SwiCago/HarviaWiFi/images/CaptivePortal2.png

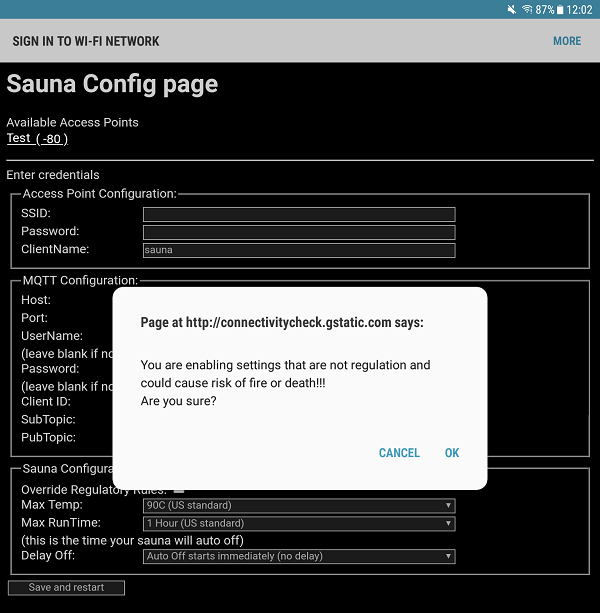
images/CaptivePortal2.png
