SwiCago/HarviaWiFi/images/CaptivePortal3.png

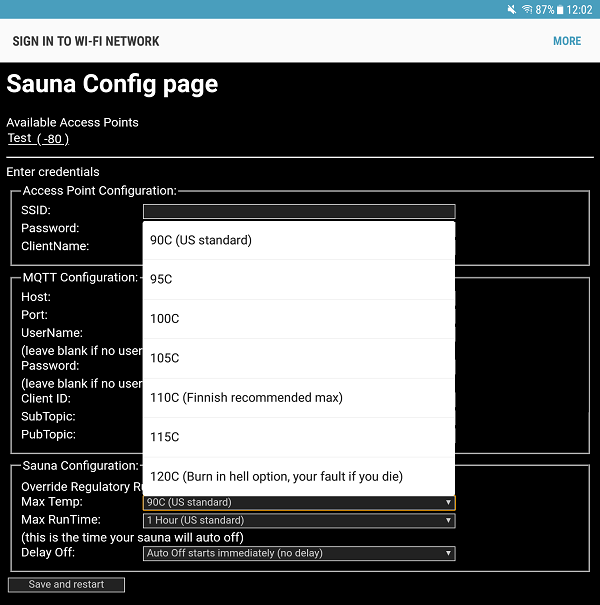
images/CaptivePortal3.png
