SwiCago/HarviaWiFi/images/CaptivePortal5.png

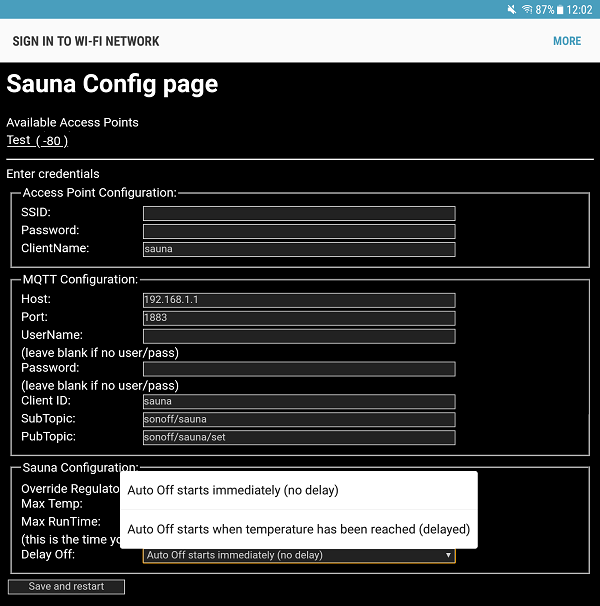
images/CaptivePortal5.png
