SwiCago/HarviaWiFi/images/CaptivePortall4.png

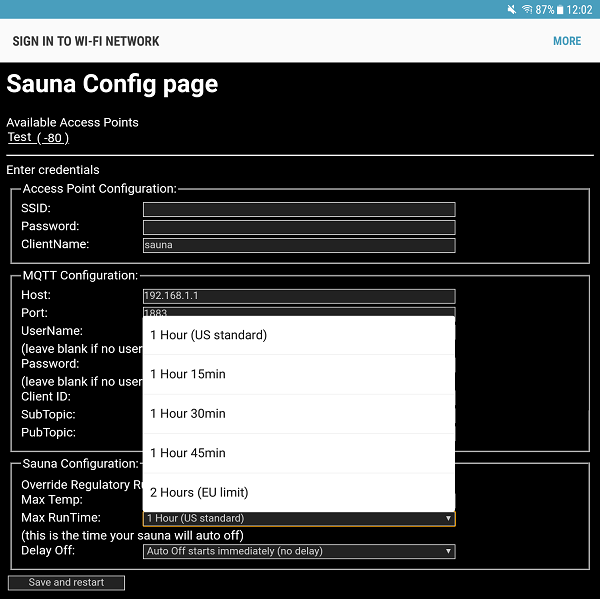
images/CaptivePortall4.png
