SwiCago/HarviaWiFi/(threads)

Thread 3 (2019-03-24):

Upgrade code from JSON 5 to JSON 6 library

SwiCago, 2019-03-24:
Code was written using JSON Arduino library 5 and not 6. If you use this code, please use library 5 to compile.
When I have time, I will upgrade the code to 6 and re-test.

jsk1000, 2019-11-25:
Hi Al,

Do you think the remote set up will work with this heater:  https://almostheaven.com/virta-heater/  - It has an electric keypad to turn it on and control the temp.

Are you able to turn the heater on with your phone when you are away from home?

Thanks in advance,
Jack
Boulder, Colorado
j a c k @ o n n o . c o m

chirojason, 2020-01-19:
Hey Jack,
Did you get it your heater working using this code?

Thanks,
Jason

SwiCago, 2020-02-24:
@jsk1000 @chirojason , wow no idea why github did not send me a notification for this question. Maybe it is because you didn't use @name to tag me. Anyhow, any heater can be converted. Even this digital one! However, you will most likely lose the digital control part, as they would be in conflict with each other over control of the primitive part(the heater).
Only way to keep keypad and make wifi, would be by making your own digital control board and have it understand keypad.

jsk1000, 2020-02-24:
Jason,

Thanks very much for this!  I appreciate it.

Best,
Jack

------ Original Message ------
From: "SwiCago" <notifications@github.com>
To: "SwiCago/HarviaWiFi" <HarviaWiFi@noreply.github.com>
Cc: "Jack Kanefield" <jack@onno.com>; "Mention"
<mention@noreply.github.com>
Sent: 2/24/2020 5:48:45 AM
Subject: Re: [SwiCago/HarviaWiFi] Upgrade code from JSON 5 to JSON 6
library (#3)

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

chirojason, 2020-02-24:
Hey Jack,
Thank you for the reply! I just figured you were really busy or not
interested in the heater build anymore. It has been over a month since I
gave up on it. I did the hardware conversion and added the fuse box to the
heater and things went great, but I could not get the Sauna software you
wrote up and running on my Sonoff. It never loaded the Captive Portal page
which never gave me the option to input my router/wifi details.
After trying many times, I ended up flashing Tasmota and using it to be an
On/Off switch using wifi so I could use my sauna. That loaded up no
problem, but I would really prefer the timer shutoff function you wrote
along with temperature. I will give it another shot this week, but I could
really use some help from someone who has more experience in the Arduino
area. I even subscribed to a few Arduino FB groups and read an Arduino book
to see what I was missing, but no luck.

If you get a few minutes and don't mind helping, I would greatly appreciate
it. I can normally figure these things out myself, but this one I am
stumped on.

Thanks again for your time and hard work documenting the sauna upgrade for
others to use!

Jason Albracht

On Mon, Feb 24, 2020 at 7:26 AM Jack Kanefield <notifications@github.com>
wrote:

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

chirojason, 2020-02-24:
Thank you for the reply! I just figured you were really busy or not
interested in the heater build anymore. It has been over a month since I
gave up on it. I did the hardware conversion and added the fuse box to the
heater and things went great, but I could not get the Sauna software you
wrote up and running on my Sonoff. It never loaded the Captive Portal page
which never gave me the option to input my router/wifi details.
After trying many times, I ended up flashing Tasmota and using it to be an
On/Off switch using wifi so I could use my sauna. That loaded up no
problem, but I would really prefer the timer shutoff function you wrote
along with temperature. I will give it another shot this week, but I could
really use some help from someone who has more experience in the Arduino
area. I even subscribed to a few Arduino FB groups and read an Arduino book
to see what I was missing, but no luck.

If you get a few minutes and don't mind helping, I would greatly appreciate
it. I can normally figure these things out myself, but this one I am
stumped on.

Thanks again for your time and hard work documenting the sauna upgrade for
others to use!

Jason Albracht

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

SwiCago, 2020-02-24:
@chirojason, are you using an iphone or android device? I tested with android, but the page to configure should be accessible at address 192.168.1.1 ... captive portal is just for convenience, but nothing keeps you fro  direct access. Heck, you could modify the code and hardcode all your details and skip the configuration part.

chirojason, 2020-09-10:
Hey SwiCago. I gave up on the sonoff board back in February with all the
corona mess and it got too hot to do the sauna. I still haven't gotten it
to find my IP address. It was working as a basic wifi switch running
Tasmota software but then I got a new router and I can not reload anything
to make it work. Would it be possible to order a new sonoff and have it
shipped to you to load the software you wrote on it and I'll Venmo or
Paypal you money for shipping and for your time if you want? I really need
to get this unit working before it starts getting cold again. My wife
mentioned tonight she's ready to get back to the sauna. I have all the
hardware conversion done and really don't want to switch it back to the
original setup. It's frustrating that I've spent so many hours on it with
no working unit now.
Any help would be so appreciated!

Thanks,
Jason Albracht

<https://www.avast.com/sig-email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>
Virus-free.
www.avast.com
<https://www.avast.com/sig-email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>
<#m_-3978630804419995655_DAB4FAD8-2DD7-40BB-A1B8-4E2AA1F9FDF2>

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

<https://www.avast.com/sig-email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>
Virus-free.
www.avast.com
<https://www.avast.com/sig-email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>
<#DAB4FAD8-2DD7-40BB-A1B8-4E2AA1F9FDF2>

jsk1000, 2020-09-10:
Hi Guys,

I have my heater 'turned on' permanently, bypassing the controls on the
heater.

Then buy a simple on/off wifi switch from amazon, and run current to the
heater when you want the sauna on.  I turn it on with my phone from
anywhere.

This is a super simple solution.

Jack

------ Original Message ------
From: "chirojason" <notifications@github.com>
To: "SwiCago/HarviaWiFi" <HarviaWiFi@noreply.github.com>
Cc: "Jack Kanefield" <jack@onno.com>; "Mention"
<mention@noreply.github.com>
Sent: 9/9/2020 8:09:50 PM
Subject: Re: [SwiCago/HarviaWiFi] Upgrade code from JSON 5 to JSON 6
library (#3)

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

SwiCago, 2020-09-11:
@chirojason , I cannot flash it for you. That would make me liable, if something were not to go as planned. I can however help you when you are ready via email.
@jsk1000 be super careful, bypassing this way could cause runaway heating, if your switch is stuck in on position!

chirojason, 2020-10-18:
@SwiCago , I understand. The world we live in is not what it used to be. Can you send me an email so we can converse that way? Mine is DrAlbracht@gmail.com
Thank you!
Jason

rockguitarpower, 2020-12-06:
Hi @SwiCago, Thanks for putting this all together. I just got an indoor sauna with a Harvia heater and looking to put together this solution.

One thing I'm not clear on is if this is compatible for an iphone (what I use) or if it will only work on android?

Sorry if that's a rookie question

Mike

SwiCago, 2020-12-10:
@rockguitarpower not sure if iphone has mqtt dash app, but I am sure there is an equivalent app.
Just remember you need an mqtt broker for my variation to work or rewrite it to support a built in webservice(pretty easy with esp8266).
Also note, if captive portal does not work when connecting to the devices initial wifi, just point your phones mobile browser to 192.168.1.1, which will bring up the config page.
Cheers

rockguitarpower, 2020-12-10:
cool, thanks for the response. I'll see what I can find and get working

arva-zz, 2020-12-27:
@SwiCago great work. I'm brainstorming as well how to make my sauna smart. On Smart home side I have Home Assistant, some fibaro z-wave dimmers, garage door and gate made smart with sonoff SV (Tasmota firmware) MQTT, some ESP32 sensors etc.. So quite flexible on.

I have Harvia PC90EE heater with a keypad. Here is the manual with electrical scheme on page 13: https://harvia.fi/wp-content/uploads/2017/05/PC70EE_PC90EE_ENDE.pdf

I would like to make it "smart", meaning to controll it and collect some data (temp, humidity). And it would be excellent if the original keypad would work.

There are three scenarios listed by priority:

1. Best would be option to read the dataflow between keypad and control unit. So that the original keypad will remain and it i can control the keypad so to say. I think this would be most complicated as well and i don't think I would be able to reverse engineer it.

2. On the electric scheme there are something like N and P termials with description "optional Control of electric heating". Maybe this would be something i can controll the heater? No documentation on harvia site or internet about this tho.

3. Swap Harvias control unit with a smart switch and losing keypad and some security functions.

So, if you could look into it and maybe help me out with some thoughts so i can move on, I would be greatful.

SwiCago, 2021-01-03:
@arva-zz
1. is your only option here. You'd need a device to dump the data between them. If you are lucky it is a simple serial device. Maybe even the main controller has a secondary serial control for 2. Optional control.
2. Not enough info here. N is neutral and is one Phase(110V)
3. You could do this, but you are missing a limit switch, which prevents your unit from going run away on you, in event of malfunction.

Thread 4 (2020-04-14):

Any suggestions for iOS-based app to use?

sazan1978, 2020-04-14:
@SwiCago Not an issue per se, but do you have any suggestions for using an iOS (iPhone or iPad) app for the sauna control using your code? I got as far as getting the code installed on Sonoff, and wiring the unit into the heater, but need some help getting controls enabled via an app. Using MQTTOOL I get what the unit is publishing -

{"celcius":-127,"fahrenheit":-196.6,"state":0,"active":0,"setpoint":60,"autooff":0}

... but have been unsuccessful in publishing any commands to it. E.g., when I publish {“state”:true} I get !root.success(): invalid JSON on set_topic...

SwiCago, 2020-04-15:
Hi @sazan1978
You publish to sonoff/sauna/set with message {"state":true} to turn it on.
As for app, the closest one I can think of is https://apps.apple.com/us/app/mqtt-buddy/id1252991874
Don't forget, you also need an mqtt broker like mosquito

sazan1978, 2020-04-15:
Thanks! Mqtt buddy doesn’t seem to function anymore. I got the Mosquitto
running and Mqtt Dash in Android emulator on my Mac. Wasn’t able to load
the JSON config comes into Dash, but was able to enter them manually. Good
news - got to communicate with sauna. Bad news - It turned on for a second,
and then the fuse box blew. No major damage, but will need to recheck all
connections. Another mystery is that the temperature readings all come back
as negative temps:

{"celcius":-127,"fahrenheit":-196.6,"state":1,"active":0,"setpoint":60,"autooff":120}

Any suggestions?

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
--
--
Alexey
214.675.2623

SwiCago, 2020-04-17:
As said, negative readings means you have a bad sensor.
Main fuse tripped or one of the bridge fuses or the fuse in the sonoff?
Double, tripple check. There are not many wires, but easy to mess up. On sonoff, one hot goes to L and the other hot to N. But make sure you don't get your hots messed up, otherwise pop.

SwiCago, 2020-05-08:
Closing for lack of response

Closed 2020-05-08.

Thread 6 (2020-11-23):

16 amp sonoff with 20 amp fuse.

james-maloney, 2020-11-23:
This is more of a question than an issue.

Have you had any issues using the Sonoff, is it not underrated given the 20A inputs?

Thanks.

Conciliator, 2020-11-29:
I also had a question about the fuse block. Those are ATM automotive fuses rated for 32V AC or DC, according to the Eaton Bussman spec sheet. How are you running 240V AC through those into the heating elements (at T1, T2 and T3) without them blowing?

SwiCago, 2020-11-30:
@james-maloney  @Conciliator the bridge fuses going to the sonoff uses very little amperage. I bet you can do 5amp fuses for those 3 and be fine too. Two fuse to sonoff are used to feed it with 240v and the sonoff uses only milliamps. The 3rd fuse is the relay trigger to the big relay in the heater unit. It only has a few amp draw to trigger that thing.

As for the 3 going to the heating elements. Well there are 3 elements on  kib80b 8kW unit, which is 33amps on 240V. 33amp / 3 elements is 11amps per element at 240VAC

DC voltage always requires thicker wire as amps flow one way, but in AC the flow in both directions. Also a wire must be thicker, the lower the voltage for the same amperage. So in reality the 20amp fuses are way over kill and will never burn out. If you want you could just solder a bridge wire instead of use a fuse or use butt terminals and make your own bridge connectors. I only chose the fuse block as an easy way to link everything together and easy replace it/reverse it. And chose all 20amp fuses, so as 1) they are not the weak link and 2) you'd only have to buy one type. How you wire it up in the end is up to you, but I can guarantee you it is over kill and will never pop a fuse or go up in flames. Mine has been in use for 2 full seasons and have never had an issue with the block or fuses..and now I am on the third season.
Also note Chicago gets bitter cold, so it takes at least an hour for my sauna to even get up to working temperature and then I bake for another 30m to 45m (at 15m intervals), so in total my sauna runs nearly 2hrs each day I use it, which is 3 - 4 times weekly

Conciliator, 2020-11-30:
@SwiCago Thanks for the thorough explanation. Much appreciated!

SwiCago, 2020-12-01:
@Conciliator  no problem...going to leave this for a few more day for @james-maloney  to get a chance to see the response and then close.

james-maloney, 2020-12-01:
Thanks for the response, very helpful!

Closed 2020-12-01.

Thread 7 (2021-01-03):

A much easier way.

jsk1000, 2021-01-03:
Here's what I did and it works great.  I bypassed the switch on my heater so the heater is permanently on.

Bought a Lutron switch on Amazon to send power to the heater via wifi and a on/off switch on my phone.

The Lutron app has an 'on/off' schedule on my phone.  So when I enter the sauna, I set the timer on my phone to automatically turn the heater off 25 minutes later.  This is an important safety feature because my sauna gets up to 220 degrees.  If I passed out in there, I would cook.

SwiCago, 2021-01-03:
Good for you, but looks like you have no temperature control and also sounds like you disabled the limiter that is built into the sauna, hence your sauna getting up to 220 degrees. You way might be easy, but very dangerous and could cause a fire. Good luck with that. My way was reviewed by Harvia(owners of Almost Heavenly sauna) and deemed good...hence why they blogged about it on their page. https://almostheaven.com/2019/02/remote-start-interview-2/

sendtoworthington, 2025-06-30:
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

Hi, could you give me more detail how you bypassed the switch? I wanted to get a lutron switch (120v) too, but I don't know which wires to bypass. Any info you have would be useful.

jsk1000, 2025-06-30:
I had an electrician bypass the "dial".  There is a 60 minute dial timer on the sauna.

Note:  It is safter to have the dial.  If a person were to pass out there, that would be dangerous.  But I have had this set up since 2021.

Closed 2021-01-03.

Thread 8 (2021-01-11):

Blocking reconnect MQTT function.

eht584, 2021-01-11:
Hey @SwiCago, really great job, I tested with my heater and it works good, but I have problem only, if connecting to MQTT broker fault (bad Internet). the reconnection function block the main loop and I can't use the Button (Sonoff) turn OFF.

Best
Eduard

eht584, 2021-01-11:
I have looked something regarding the MQTT reconnect problems, is currently so that as soon as the connection to the broker goes away the ESP is no longer accessible because he hangs in the reconnect loop. I have tried something around and found that the solution is actually already in the folder:

https://github.com/knolleary/pubsubclient/blob/master/examples/mqtt_reconnect_nonblocking/mqtt_reconnect_nonblocking.ino.
Here is continuously trying to reestablish the connection without blocking the loop.

SwiCago, 2021-01-20:
@eht584 I have no idea, as I have never had any of my ESPs hang using MQTT. I run about 20 devices using MQTT technology. What broker are you using? I use mosquitto on a router running openwrt linux on it.

SwiCago, 2021-01-20:
@eht584  if you are willing, try changing the following lines
Swap line 207 with if(mqtt_client.connected()){Serial.println("MQTT connected");}
Swap line 216 with a return;
Swap line 543 with if(mqtt_client.connected()){mqtt_client.loop();}

See if that solves your problem. Basically this will skip the connect mqtt loop and try it again on next main loop

Closed 2021-02-22.

Thread 10 (2021-05-10):

No Output from Sonoff When Temp Sensor Plugged In

skyej944, 2021-05-10:
@SwiCago
Sauna worked and displays temp but shutoff at about 70°C and won't Output to contactor with the temp sensor plugged in. Any ideas? Using sensor that came with the TH16

Closed 2021-05-10.

Thread 11 (2021-08-02):

Bypassing timer

TristanBrotherton, 2021-08-02:
Hi there, I apologies for the format of this as it's not an issue with your project, but I had a question if you have the time.

I'd like to externally control the power to our KIP and bypass the timer.

I wondered if I could ask your opinion on how to safely take the timer out of the equation so that the heater came on when power was supplied, but still used it's thermostat / limiter.

Warm regards,

Tristan

SwiCago, 2021-08-04:
Hi @TristanBrotherton , yes this can be done.
You would swap the timer out with a heavy duty toggle switch.
There are three wires going to the timer. The two in the left side of the timer on the diagram(also next to each other on physical device) would be connected to the toggle switch. The 3rd wire on the right side of timer on the diagram would be disconnected and wrapped in electrical tape. It would not be connected to anything.
Make sure to disconnect power before doing mods.
Green = toggle switch
Red = disconnected and wrapped
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

TristanBrotherton, 2021-08-04:
I really appreciate your response - thank you. I intend to keep a timer, just external to the sauna so it can be toggled on remotely. Whilst taking my time to implement your solution. Thank you again!

aypodf, 2022-02-28:
Hi, thank you so much for putting this useful project together! I'm also interested in this alternative, is there a particular heavy-duty toggle switch you would recommend. Presumably the amp rating should match the heater, right?

Thanks again!

SwiCago, 2022-03-18:
@aypodf any standard automotive or home switch will work. The main current goes through the giant relay/contactor. The timer/limiter themselves do not feed much current to turn that giant relay/contactor on/off.

denmanbw, 2025-02-12:
Thanks Mitch Bogart! I like your setup and may consider the same set up. Do you happen to have a sketch or diagram showing how all your components work together?

MitchBogart, 2025-02-12:
Hi  denmanbw,

Yes, glad you like it. So does my son and family in whose sauna it's all
going.  I made a rough sketch for myself.  I'm in the process of using
pictures instead of pure schematic.  The timer electronic total disable
works,  my red light toggle switch controlling the contactor works.  I
changed some of the parts and I'm making it into a color interconnect
diagram for people who don't work well with schematics.

Is the Github entry still closed?
Mitch

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

denmanbw, 2025-02-12:
Hi @MitchBogart (BTW, I can’t figure out how to reply on GitHub). It does say entry closed, but I’m seeing your updates. Thanks so much for sharing with us. I’ve looked at other options, which are more costly. This sounds like a very good solution!

MitchBogart, 2025-02-12:
Hi Denmanbw,

Glad you like it!
I finished transforming my "for me only" sketches and posted it in 3
portions.
The first shows the use of the DPDT toggle switch on bottom of sauna to
implement benign mod enable both retro mode and new full anytime control.
The second shows the use of an additional wall switch control sauna heater
control via a 120vac contactor relay controlled by the wall toggle switch
with pilot light.
The third (and so far final) one shows:
    1) The addition of the 24 hour pushbutton digital timer, with Countdown
mode in addition to the toggle switch.
    2) The addition of a Shelly 1 Plus for remote (and local) control of
sauna power via the Toggle switch and/or the Countdown Timer".

The Toggle switch and the Digital Timer switch are in parallel.  Thus,
locally either one can be used to start the sauna, but both must be off
to locally stop the sauna.
It's advised to shut off the toggle switch right after you energize the
Timer; otherwise the toggle switch will keep the sauna on even after the
timer is off.
You can always turn the sauna on and off (regardless of the toggle and
digital timer) via the remote Shelly App.

I think I can post because I am a long time member of Github.

Best regards,
Mitch

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

MitchBogart, 2025-02-13:
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

SwiCago, 2025-02-13:
@MitchBogart , @denmanbw
Glad to see there is still some interest in this project. Hope you all enjoy your saunas as much  as I do.

denmanbw, 2025-02-14:
This is very helpful and appreciated. Again, thank you @MitchBogart for sharing! Ive been considering something like this:

https://www.amazon.com/SURAIELEC-Electrical-Distribution-Waterproof-Decorations/dp/B0D9LCZ11S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

This requires a neutral which I can pull or consider a WiFi switch not requiring a neutral.

I like your bypass and retro modes via the toggle. I’m open to feedback but feel this simple set up would work for me . . .

sendtoworthington, 2025-06-11:
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

Hi! I am just coming across this - What gauge wire did you use for the timer bypass part (I am only looking to hook that up to a Lutron Caseta switch outside the sauna room). My concern is using regular wire would melt if it gets too hot!? Thanks in advance!

Closed 2021-08-05.

Thread 12 (2021-12-19):

Continue to use timer for manual control

johnnyguitar77, 2021-12-19:
Hello,
Thank you for all your work, however I was wanting to implement this project and it seems like manual control is lost. I am hoping to combine manual control with wireless control at the same time. I was wondering if the following wire diagram made sense to you where the timer is kept in parallel with the Sonoff and the sauna thermometer is not removed. I understand that that would mean that one wouldn't be able to exceed the manually set temperature through wireless control, but that would be fine for me:
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

Also, if this wiring schematic makes sense, do you know which gauge wires I should use?

Thank you again for all the work you've done on this project. I think it's great to be able to add wireless control to these Harvia heaters.

SwiCago, 2022-01-29:
Hi @johnnyguitar77 sorry for not seeing this question earlier. Yes you could wire it like this and preserve the original timer. You could also add keep the thermostat too as you have, set it to its highest setting and then wifi can still control temperature and on/off state. Like this in theory you can still use manual controls or wifi.
No granted you will not be able to go higher than US regulation temps with the manual thermostat still in place. As for wiring size, 12ga is what you would use.

Closed 2022-02-02.

Thread 13 (2022-08-25):

Fuse choice

lazy0ne, 2022-08-25:
Looking at your hardware solution, I had a concern.  The fuse block and fuses you used are designed for 12/24 VDC.  You are using these fuses at 240VAC.  If a fault were to occur, you may experience arcing, which will not provide the intended protection.  You probably should use a 250V fuse block and fuses.

SwiCago, 2022-10-05:
The fuses are just dummies. They are not there to actually prtect anything, only allow for easy reversal w/o having  to solder or cut wires.
I have ran mine in this config for the last 4 years w/o issues. If you want you could perma bridge the connections, instead of using a block/fuses. This was just a fast reversible way to do it. But thanks for your concern

Closed 2022-10-05.

Thread 14 (2022-09-20):

TH16 installation

xmozart, 2022-09-20:
Where did you install the Sonoff TH16 unit? You can't put it inside the heater, cause it is too hot. And you can't put it outside of the sauna, cause it could be too cold. So wondering where to put it.

SwiCago, 2022-10-05:
It is in the electrical box on the outside of my sauna. Look at pic, right side.

Closed 2022-10-05.

Thread 16 (2024-01-29):

Harvia Senator 9KW

blissi, 2024-01-29:
Hi,
I have a Senator 9KW which has 3 phases.
Does this also work with that kind of heaters? If not, is there a similar project somewhere? Couldn't find something, but English is not my native language so maybe my search was wrong...

Thanks,
Steven

SwiCago, 2025-02-13:
@blissi , sorry for the late response. My wife and I took over a business and it has consumed all my time.
Anyhow, in theory yes it should work as well. The large contactor has the 3 phase going to it and also most likely a N (neutral line) which is then used with one of the phases, most likely L1 to power the timer and thermostat, which in turn enable/disable the large contactor. I would have to see the schematic of the heater in question to be 100% sure. If you can find it, re-open this issue and paste the link. I will give it a review for you.
Again sorry for the late response

Thread 17 (2024-12-04):

Compatible with Harvia Xenio CX45?

GizuMoca, 2024-12-04:
Hello, does this fit the CX45?

SwiCago, 2025-02-13:
Hi @GizuMoca , I would not know. If the schematic is similar, then yes. I would have to see the schematic to tell you for sure. If you find it, re-open this issue, paste the link and I will have a quick look for you.

Closed 2025-02-13.
