SwiCago/HarviaWiFi/(commit log)

2019-02-02 Board image
2021-08-11 Update SAUNA.ino
    Fixed auto timer.
    [SAUNA.ino]
